santiagoruizvt/Proyecto_Potencia/README.md

# Proyecto_Potencia
Repositorio destinado al proyecto de la materia Electrónica de Potencia
