santiagoruizvt/Proyecto_Potencia/Código Firmware (Arduino)/control_de_energia/README.md

## Proyecto Electrónica de Potencia

# CONTROL DE ENERGÍA POR TIEMPOS DE OPERACIÓN

## Pines del Arduino UNO utilizados:
                
0. Salida_Rele
1. 
2. 
3. RTC_SQW
4. LCD_Backlight
5. Encoder_Switch
6. LCD_EN
7. LCD_RS
8. Encoder_OutputB
9. Encoder_OutputA
10. SD_CS
11. SD_MOSI
12. SD_MISO
13. SD_SCK
14. (A0)	LCD_D4
15. (A1)	LCD_D5
16. (A2)	LCD_D6
17. (A3)	LCD_D7
18. (A4)	RTC_SDA
19. (A5)	RTC_SCL

**Planilla para la correcta interpretación del guardado de variables en memoria:** 

https://docs.google.com/spreadsheets/d/1By1mbL209ivBhk7KslNObIQkLeI79eL5sD7_9IqCB14/edit?usp=sharing
