santiagoruizvt/Proyecto_Potencia/STLs/Base_Potencia_Corregido.stl

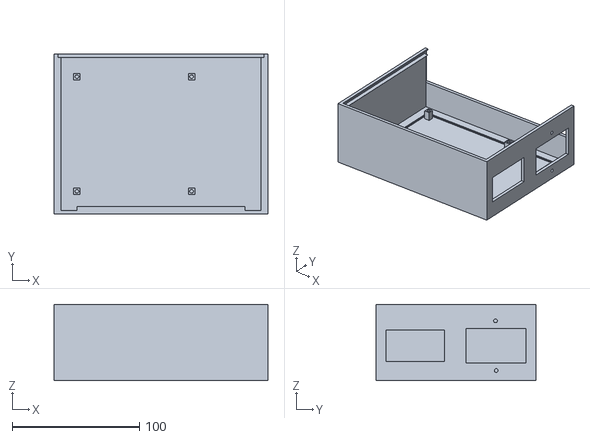
[picture p1: CAD file, 2023-07-11]
STLs/Base_Potencia_Corregido.stl
168.0 x 126.0 x 60.0
