santiagoruizvt/Proyecto_Potencia/STLs/Control_Energia_Case v6.stl

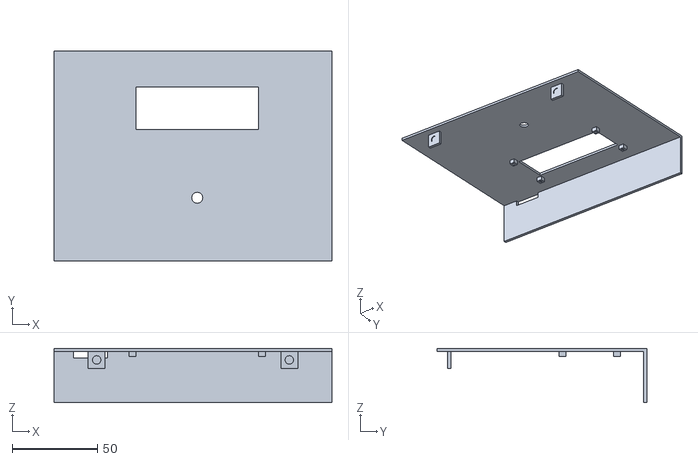
[picture p2: CAD file, 2023-07-11]
STLs/Control_Energia_Case v6.stl
163.0 x 123.0 x 31.8
