santiagoruizvt/Proyecto_Potencia/Manuales/Elección de microcontrolador/Diagrama en Bloques/Diagrama en Bloques.png

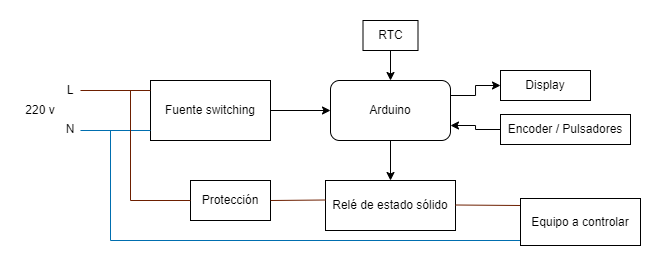
Manuales/Elección de microcontrolador/Diagrama en Bloques/Diagrama en Bloques.png
