santiagoruizvt/Proyecto_Potencia/Esquemático/Control_Energia_Tiempos_Operacion/Control_Energia_Tiempos_Operacion.kicad_pcb

## KiCad design Esquemático/Control_Energia_Tiempos_Operacion/Control_Energia_Tiempos_Operacion.kicad_pcb (2023-07-11)

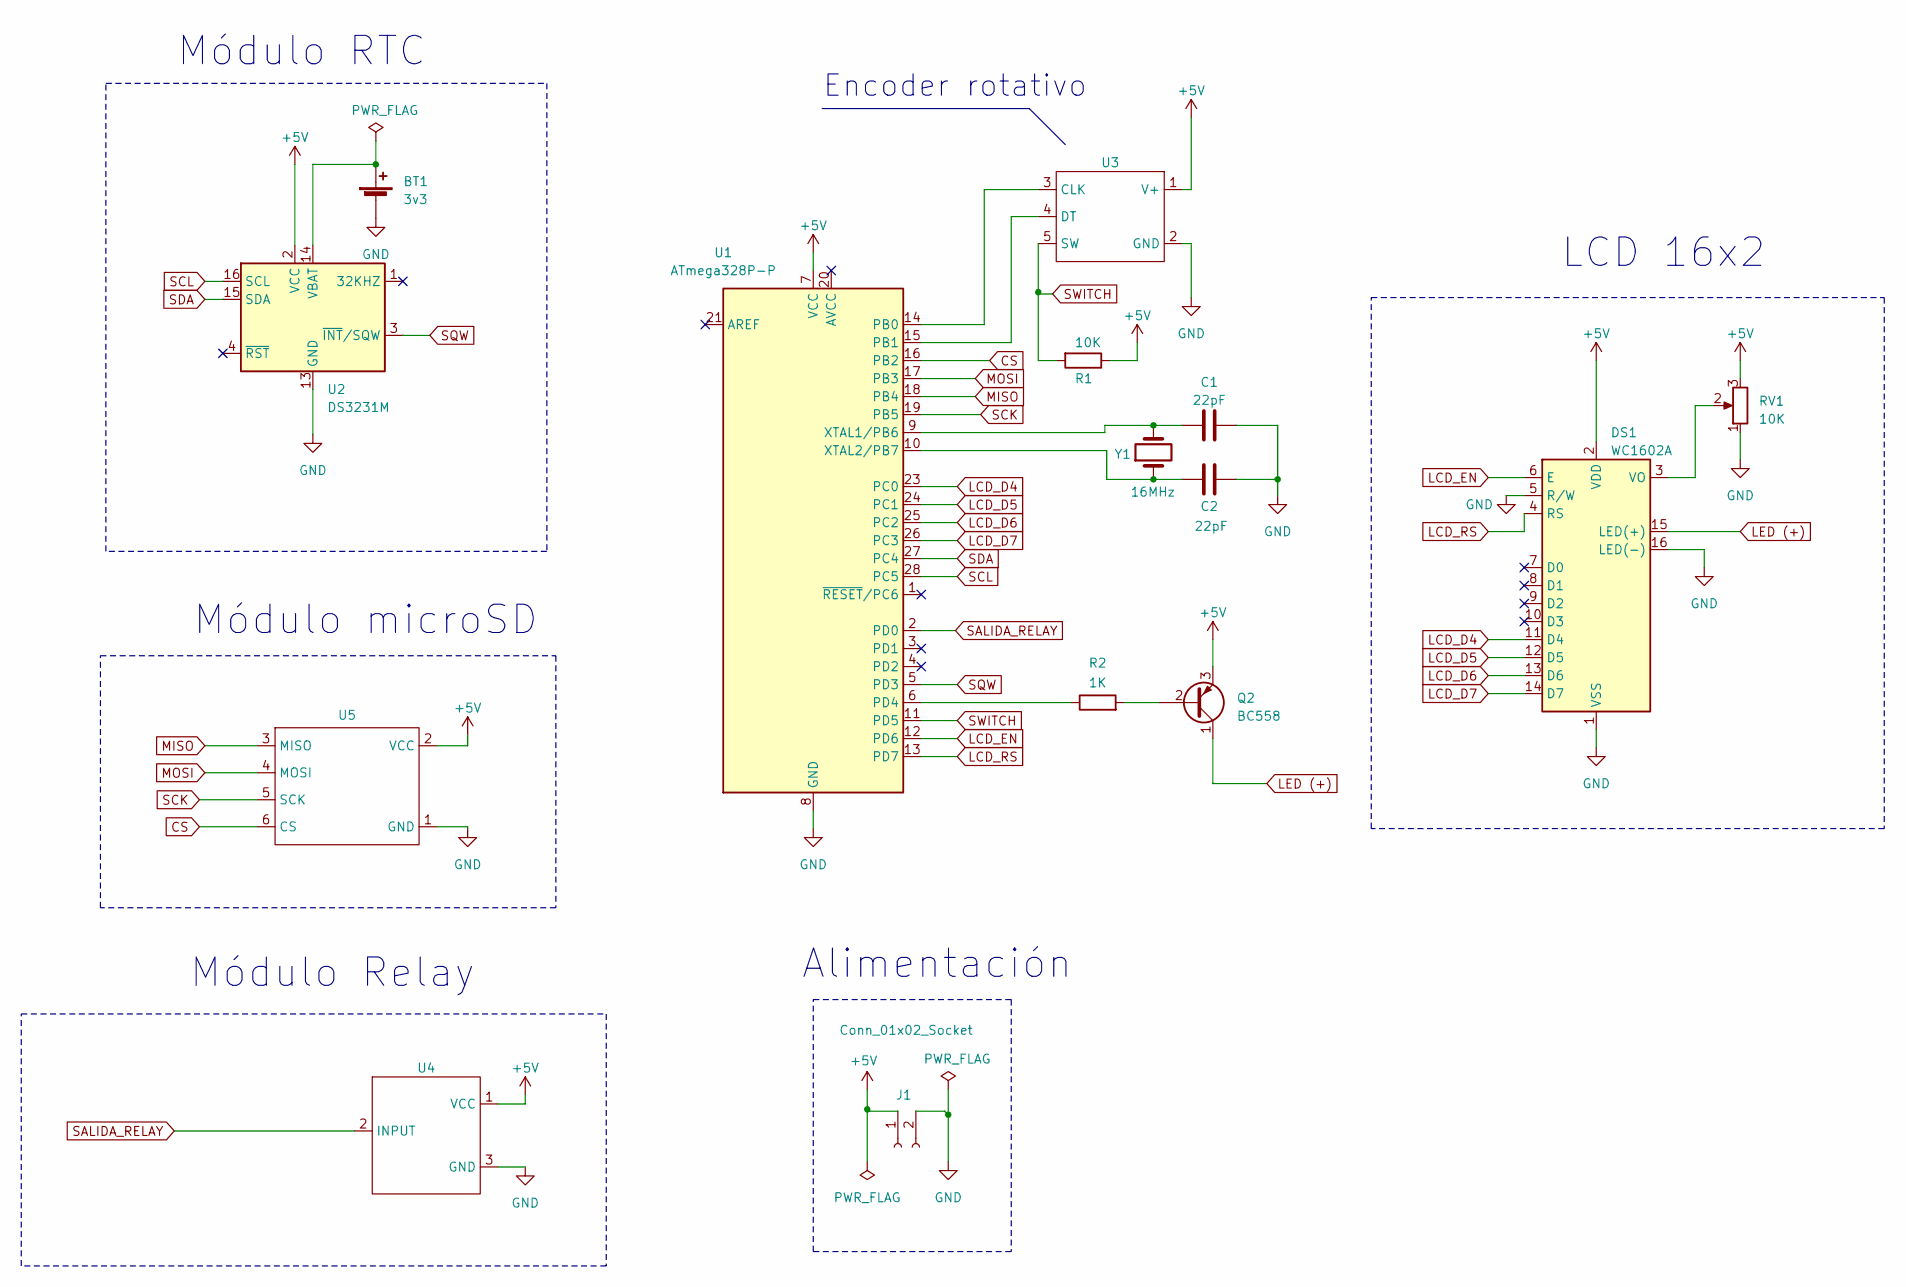
[picture p39: schematic Control_Energia_Tiempos_Operacion.kicad_sch, Control de Energía por Tiempos de Operación]

Parts:
BT1: 3v3
C1, C2: 22pF; C_Disc_D5.0mm_W2.5mm_P2.50mm
DS1: WC1602A; IDC-Header_2x06-1MP_P2.54mm_Latch6.5mm_Vertical
J1: Conn_01x02_Socket; TerminalBlock_bornier-2_P5.08mm
Q2: BC558; TO-92_Inline
R1: 10K; R_Axial_DIN0207_L6.3mm_D2.5mm_P10.16mm_Horizontal
R2: 1K; R_Axial_DIN0207_L6.3mm_D2.5mm_P10.16mm_Horizontal
RV1: 10K; Potentiometer_Bourns_3296W_Vertical
U1: ATmega328P-P; DIP-28_W7.62mm
U2: DS3231M; PinSocket_2x04_P2.00mm_Vertical
U3: IDC-Header_2x03_P2.54mm_Vertical
U4: PinSocket_1x03_P2.00mm_Vertical
U5: PinSocket_1x06_P2.00mm_Vertical
Y1: 16MHz; Crystal_HC49-4H_Vertical

Connections:
+5V: DS1.2 (VDD), J1.1, Q2.3 (E), R1.1, RV1.3, U1.7 (VCC), U2.2 (VCC), U3.1 (V+), U4.1 (VCC), U5.2 (VCC)
CS: U1.16 (PB2), U5.6 (CS)
GND: BT1.2 (-), C1.2, C2.2, DS1.1 (VSS), DS1.5 (R/W), DS1.16 (LED(-)), J1.2, RV1.1, U1.8 (GND), U1.22 (GND), U2.5 (GND), U2.6 (GND), U2.7 (GND), U2.8 (GND), U2.9 (GND), U2.10 (GND), U2.11 (GND), U2.12 (GND), U2.13 (GND), U3.2 (GND), U4.3 (GND), U5.1 (GND)
LCD_D4: DS1.11 (D4), U1.23 (PC0)
LCD_D5: DS1.12 (D5), U1.24 (PC1)
LCD_D6: DS1.13 (D6), U1.25 (PC2)
LCD_D7: DS1.14 (D7), U1.26 (PC3)
LCD_EN: DS1.6 (E), U1.12 (PD6)
LCD_RS: DS1.4 (RS), U1.13 (PD7)
LED (+): DS1.15 (LED(+)), Q2.1 (C)
MISO: U1.18 (PB4), U5.3 (MISO)
MOSI: U1.17 (PB3), U5.4 (MOSI)
unnamed: BT1.1 (+), U2.14 (VBAT)
unnamed: DS1.3 (VO), RV1.2
unnamed: Q2.2 (B), R2.2
unnamed: U1.14 (PB0), U3.3 (CLK)
unnamed: U1.15 (PB1), U3.4 (DT)
unnamed: R2.1, U1.6 (PD4)
unnamed: C1.1, U1.9 (XTAL1/PB6), Y1.2
unnamed: C2.1, U1.10 (XTAL2/PB7), Y1.1
SALIDA_RELAY: U1.2 (PD0), U4.2 (INPUT)
SCK: U1.19 (PB5), U5.5 (SCK)
SCL: U1.28 (PC5), U2.16 (SCL)
SDA: U1.27 (PC4), U2.15 (SDA)
SQW: U1.5 (PD3), U2.3 (~INT/SQW)
SWITCH: R1.2, U1.11 (PD5), U3.5 (SW)

Notes on the sheet:
Alimentación
LCD 16x2
Encoder rotativo
Módulo microSD
Módulo RTC
Módulo Relay

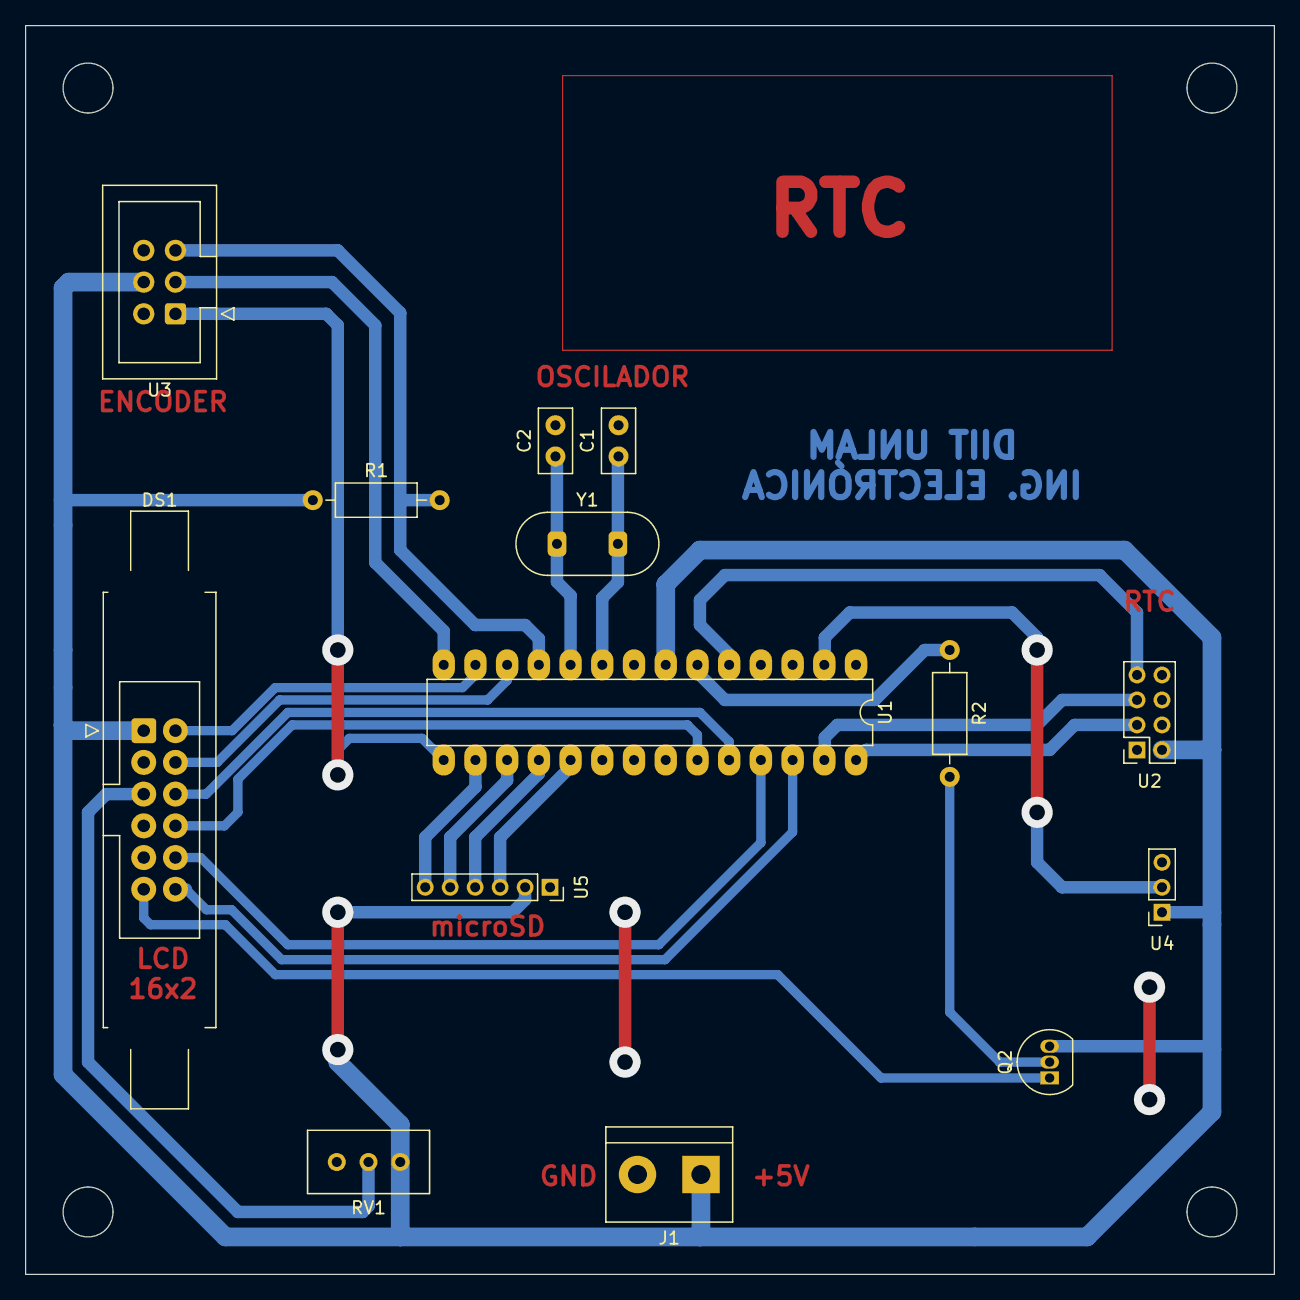
[picture p40: board Control_Energia_Tiempos_Operacion.kicad_pcb from above]

Board: 2 copper layers, 100.0 x 100.0 mm, 14 parts (0 on the bottom side), 25 nets.
