santiagoruizvt/Proyecto_Potencia/(commit log)

2023-05-18 Agregado del programa inicial. LCD y encoder para seleccionar días
2023-05-18 Corrección encoder.
2023-05-18 Agregado de excel
    [Guardado de variables en memoria.xlsx, Pantallas Display 16x2.xlsx]
2023-05-22 Update LCD_Encoder_Dias.ino
    Se agrega el manejo de los distintos menúes, simulando el RTC con un Timer.
2023-05-23 Se agrega EEPROM - Programación Semanal
    Por ahora la programación semanal acepta cualquier valor. Hay que asegurarse que los encendidos ocurran antes que los apagados y que los rangos no se superpongan (entre otras cosas a detallar).
    Video del funcionamiento:
    https://drive.google.com/file/d/1EcfEMQKbVpGrow3jqm48_inyMvtoU40a/view?usp=share_link
    Guardado de variables en memoria:
    https://docs.google.com/spreadsheets/d/1By1mbL209ivBhk7KslNObIQkLeI79eL5sD7_9IqCB14/edit?usp=sharing
2023-05-24 Agregado de Salida_Rele y encabezados de funciones
    Se usa como salida para relé el pin 13 para ver su estado con el led de la placa del Arduino UNO.
    Se enciende si está dentro de los rangos programados, y se apaga si no lo está.
    Por el momento se deja por defecto que es siempre domingo, hasta agregar las funciones del RTC.
2023-05-25 Cambio ubicación de los pines del LCD
    Modificación previa a agregar el módulo RTC para liberar el pin de interrupción.
2023-05-25 Agregado de RTC y validación de fechas
    - Se agrega lectura y grabación del RTC.
    - Se validan las fechas seleccionadas en el Reloj.
    - Se muestra el día de semana en la pantalla principal y en el ajuste de Reloj.
    - Se modifican las posiciones de la memoria para rangos de eventos (arranca en lunes, termina en domingo):
    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
2023-05-26 Agregado de Menú Feriados
    - Se agrega lectura y grabación de feriados
    - Se agrega #define para el DEBUG_SERIE
2023-05-26 Agregado de README con posibles mejoras
2023-05-27 Se agrega control de backlight del LCD
    Se utiliza el pin 4 como salida para que, si pasa un minuto sin tocar el encoder, se apague el backlight.
2023-05-28 Agregado de pines utilizados en Readme
2023-06-01 Agregado de proyecto de KiCad con circuito esquemático sin uSD
    [Control_Energia_Tiempos_Operacion.kicad_pcb, Control_Energia_Tiempos_Operacion.kicad_sch]
2023-06-01 ERC completo en esquemático
    [Control_Energia_Tiempos_Operacion.kicad_sch]
2023-06-12 Esquemático y PCBs actualizado, incluye uSD
    [Control_Energia_Tiempos_Operacion.kicad_pcb, Control_Energia_Tiempos_Operacion.kicad_sch]
2023-06-12 Corrección PCB
    [Control_Energia_Tiempos_Operacion.kicad_pcb]
2023-06-19 Update README.md
    Modificaciones en los pines utilizados y agregado de pines para la microSD.
2023-06-19 Lectura/grabación de microSD y más
    Cambios:
    - Se agrega la lectura y grabación de microSD para configurar los feriados.
    - Se cambian las posiciones del relé y del switch del encoder.
    - Se guardan variables en PROGMEM para tener más espacio en el código.
    - Algunas variables globales pasan a ser locales para tener más espacio en el código.
    - Se modifican los buffers fijos de lcd.print o Serial.print para tener más espacio en el código.
    - Se saca el timer interno dejandolo con el define TIMER_INTERNO.
    - Se lee constantemente el RTC en lugar de usar la interrupción cada un minuto.
2023-06-25 Se leen los eventos de la microSD
    - Se modifica la lectura de los feriados de la microSD
    - Se agrega la lectura de los eventos de la microSD
    - Se comenta la grabación de los feriados en la microSD hasta agregar también la grabación de los eventos.
2023-06-26 Guarda en la microSD los feriados y eventos
    Se agrega función para que al realizar cualquier cambio desde el dispositivo, regenere el archivo en la microSD (si está colocada) guardando la programación de feriados y eventos.
2023-06-26 Archivo de programación default
    El archivo FERIADOS.txt por default incluye lo siguiente:
    - Setea los feriados del 2023
    - Setea los eventos de la semana en los horarios que se cursa en la facultad
    Lunes a viernes: turno mañana, tarde y noche
    Sabado: turno mañana y tarde
    Domingo: apagado
2023-07-03 Se agregan los manuales
    - Elección de microcontrolador
    - Manual de Usuario
    - Manual Técnico (Falta link de video)
2023-07-03 Update control_de_energia.ino
    Modificación para que cuando se cargue la programación por microSD, vuelva a cargar los rangos del día por si se modificaron
2023-07-03 Add files via upload
    Se agrega link de video
2023-07-11 Manual Técnico Rev002
    Se agrega la interpretación del archivo "feriados.txt" de la micro SD
2023-07-11 Actualización de PCB, se pueden corregir algunas huellas para el armado de futuros prototipos.
    [Control_Energia_Tiempos_Operacion.kicad_pcb, Control_Energia_Tiempos_Operacion.kicad_sch]
2023-07-11 Agregado de archivos STLs de la base y tapa
    [Base_Potencia_Corregido.stl, Control_Energia_Case v6.stl]
2023-07-11 Corrección de lista de materiales PNP
2023-07-11 Subo el zip enviado por Miel
